blus-audio/hardware/readme.md

# Blus hardware

This repository contains hardware designs for the blus series of audio equipment.

- The [blus mini](./blus-mini) - a small 4x25 W digital amplifier with DSP and various digital inputs.
