blus-audio/hardware/blus-mini-mk2/kicad/blus-mini-mk2.kicad_pcb

## KiCad design blus-mini-mk2/kicad/blus-mini-mk2.kicad_pcb (2024-11-22)

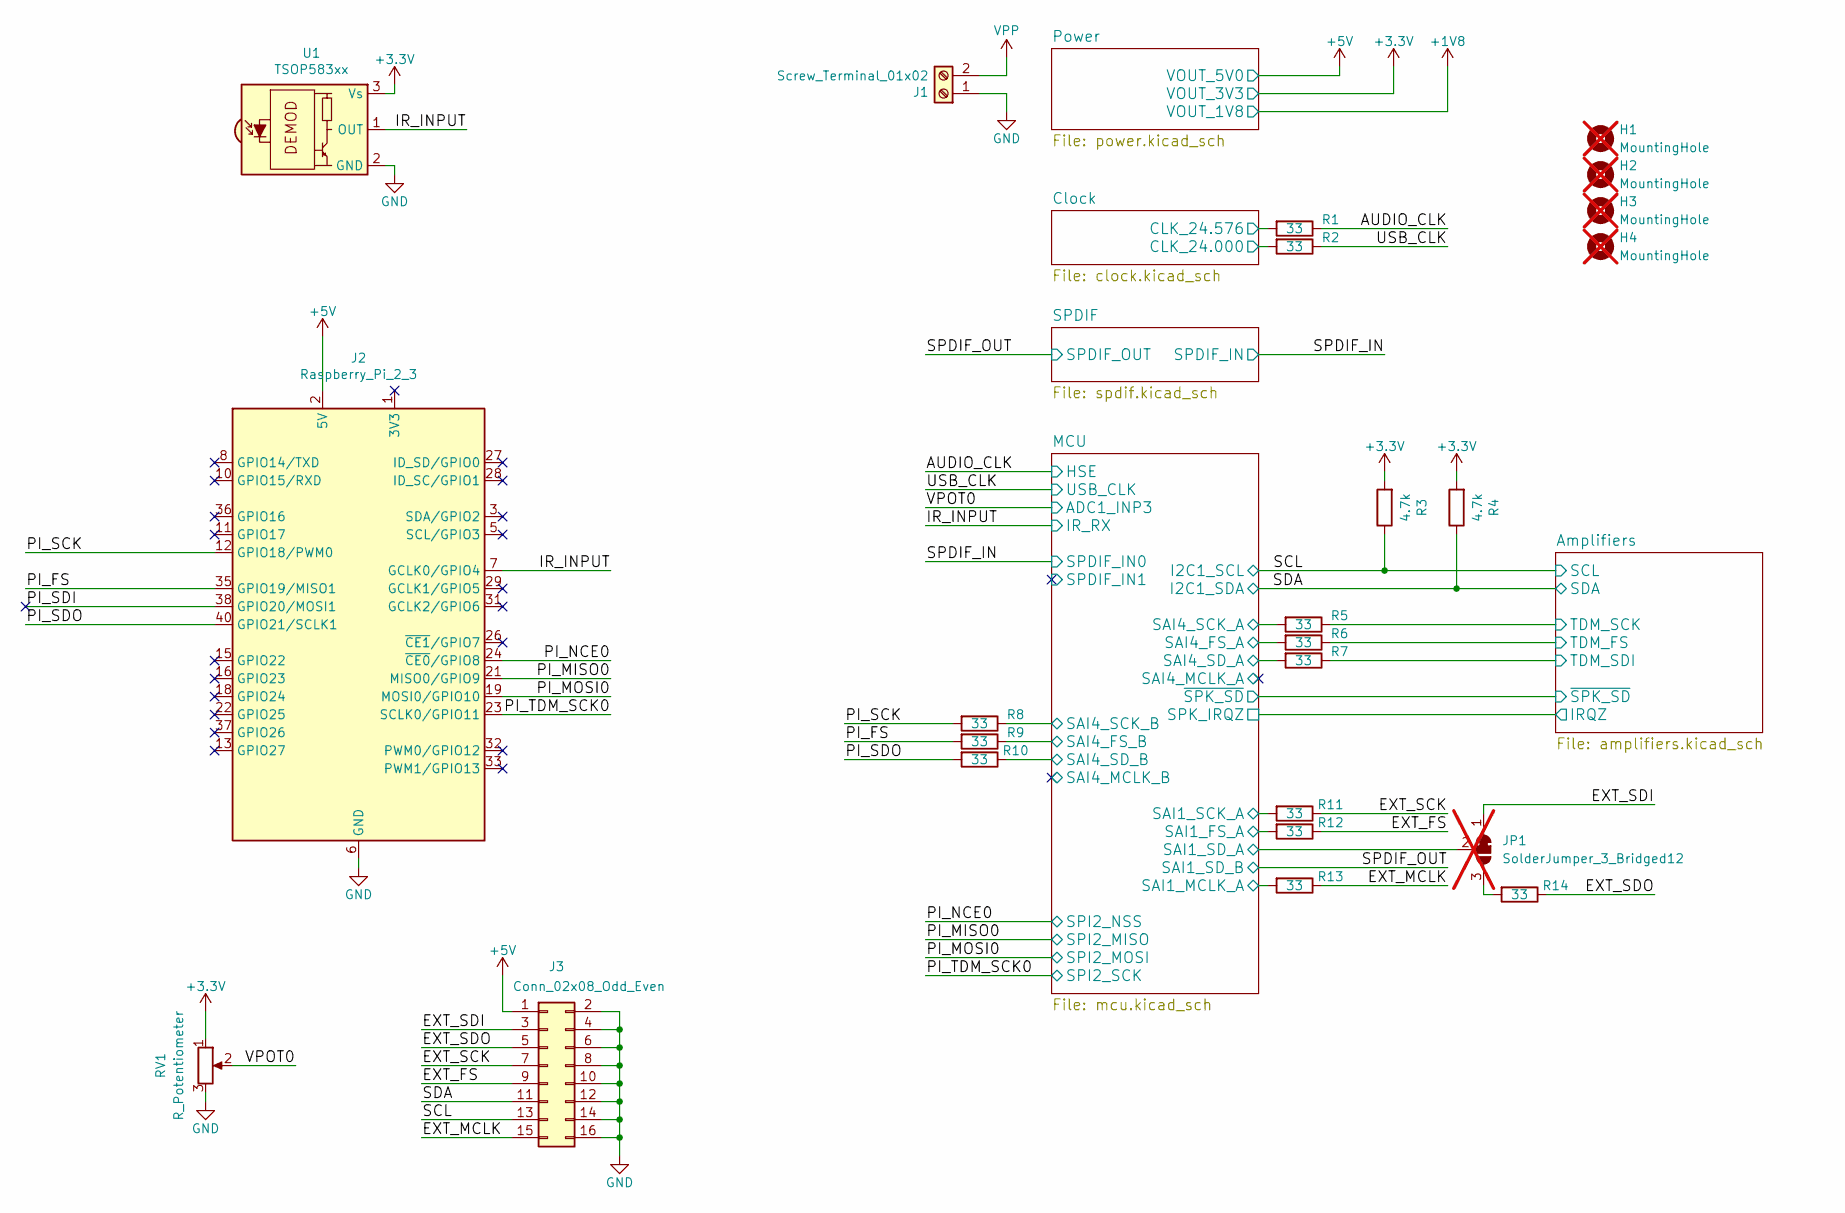
[picture p3: schematic blus-mini-mk2.kicad_sch, blus mini mk2]

Parts:
H1, H2, H3, H4: MountingHole; MountingHole_3.2mm_M3_ISO7380_Pad; not fitted
J1: Screw_Terminal_01x02; wuerth_691216410002
J2: Raspberry_Pi_2_3; PinSocket_2x20_P2.54mm_Vertical
J3: Conn_02x08_Odd_Even; IDC-Header_2x08_P2.54mm_Horizontal
JP1: SolderJumper_3_Bridged12; SolderJumper-3_P1.3mm_Bridged12_RoundedPad1.0x1.5mm; not fitted
R1, R2, R5, R6, R7, R8, R9, R10, R11, R12, R13, R14: 33; R_0402_1005Metric; MPN C25105
R3, R4: 4.7k; R_0402_1005Metric; MPN C25900
RV1: R_Potentiometer; Potentiometer_Bourns_PTV09A-1_Single_Vertical
U1: TSOP583xx; Vishay_MINICAST-3Pin

Connections:
+3.3V: R3.2, R4.2, RV1.1, U1.3 (Vs); also elsewhere on the board
+5V: J2.2 (5V), J2.4 (5V), J3.1; also elsewhere on the board
/AUDIO_CLK: R1.1; also elsewhere on the board
/Amplifiers/TDM_FS: R6.1; also elsewhere on the board
/Amplifiers/TDM_SCK: R5.1; also elsewhere on the board
/Amplifiers/TDM_SDI: R7.1; also elsewhere on the board
/Clock/CLK_24.000: R2.2; also elsewhere on the board
/Clock/CLK_24.576: R1.2; also elsewhere on the board
/EXT_FS: J3.9, R12.1
/EXT_MCLK: J3.15, R13.1
/EXT_SCK: J3.7, R11.1
/EXT_SDI: J3.3, JP1.1 (A)
/EXT_SDO: J3.5, R14.1
/IR_INPUT: J2.7 (GCLK0/GPIO4), U1.1 (OUT); also elsewhere on the board
/MCU/SAI1_FS_A: R12.2; also elsewhere on the board
/MCU/SAI1_MCLK_A: R13.2; also elsewhere on the board
/MCU/SAI1_SCK_A: R11.2; also elsewhere on the board
/MCU/SAI1_SD_A: JP1.2 (C); also elsewhere on the board
/MCU/SAI4_FS_A: R6.2; also elsewhere on the board
/MCU/SAI4_FS_B: R9.1; also elsewhere on the board
/MCU/SAI4_SCK_A: R5.2; also elsewhere on the board
/MCU/SAI4_SCK_B: R8.1; also elsewhere on the board
/MCU/SAI4_SD_A: R7.2; also elsewhere on the board
/MCU/SAI4_SD_B: R10.1; also elsewhere on the board
/PI_FS: J2.35 (GPIO19/MISO1), R9.2
/PI_MISO0: J2.21 (MISO0/GPIO9); also elsewhere on the board
/PI_MOSI0: J2.19 (MOSI0/GPIO10); also elsewhere on the board
/PI_NCE0: J2.24 (~CE0/GPIO8); also elsewhere on the board
/PI_SCK: J2.12 (GPIO18/PWM0), R8.2
/PI_SDI: J2.38 (GPIO20/MOSI1)
/PI_SDO: J2.40 (GPIO21/SCLK1), R10.2
/PI_TDM_SCK0: J2.23 (SCLK0/GPIO11); also elsewhere on the board
/SCL: J3.13, R3.1; also elsewhere on the board
/SDA: J3.11, R4.1; also elsewhere on the board
/USB_CLK: R2.1; also elsewhere on the board
/VPOT0: RV1.2; also elsewhere on the board
GND: J1.1, J2.6 (GND), J2.9 (GND), J2.14 (GND), J2.20 (GND), J2.25 (GND), J2.30 (GND), J2.34 (GND), J2.39 (GND), J3.2, J3.4, J3.6, J3.8, J3.10, J3.12, J3.14, J3.16, RV1.3, U1.2 (GND); also elsewhere on the board
unnamed: JP1.3 (B), R14.2
VPP: J1.2; also elsewhere on the board

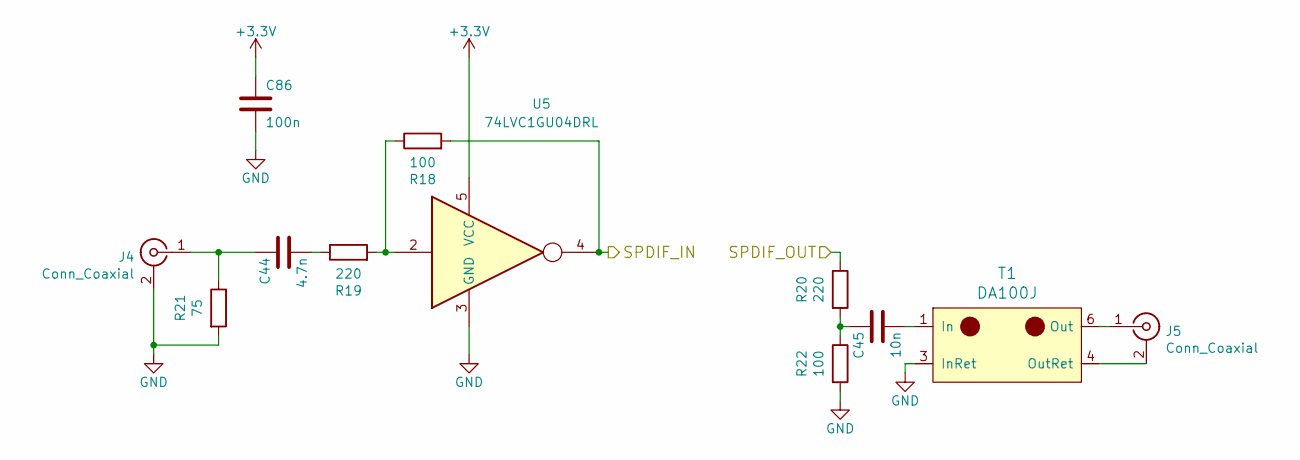
[picture p4: schematic spdif.kicad_sch, blus mini mk2]

Parts:
C44: 4.7n; C_0402_1005Metric
C45: 10n; C_0402_1005Metric; MPN C15195
C86: 100n; C_0402_1005Metric; MPN C307331
J4, J5: Conn_Coaxial; cui_rcj_02x
R18, R22: 100; R_0402_1005Metric; MPN C25076
R19, R20: 220; R_0402_1005Metric; MPN C25091
R21: 75; R_0402_1005Metric; MPN C25133
T1: DA100J; SOIC-6
U5: 74LVC1GU04DRL; SOT-553; MPN C2877548

Connections:
+3.3V: C86.1, U5.5 (VCC); also elsewhere on the board
/SPDIF_IN: R18.2, U5.4; also elsewhere on the board
/SPDIF_OUT: R20.1; also elsewhere on the board
GND: C86.2, J4.2 (Ext), R21.2, R22.2, T1.3 (InRet), U5.3 (GND); also elsewhere on the board
unnamed: C44.2, R19.1
unnamed: C45.1, R20.2, R22.1
unnamed: C44.1, J4.1 (In), R21.1
unnamed: J5.2 (Ext), T1.4 (OutRet)
unnamed: J5.1 (In), T1.6 (Out)
unnamed: R18.1, R19.2, U5.2
unnamed: C45.2, T1.1 (In)

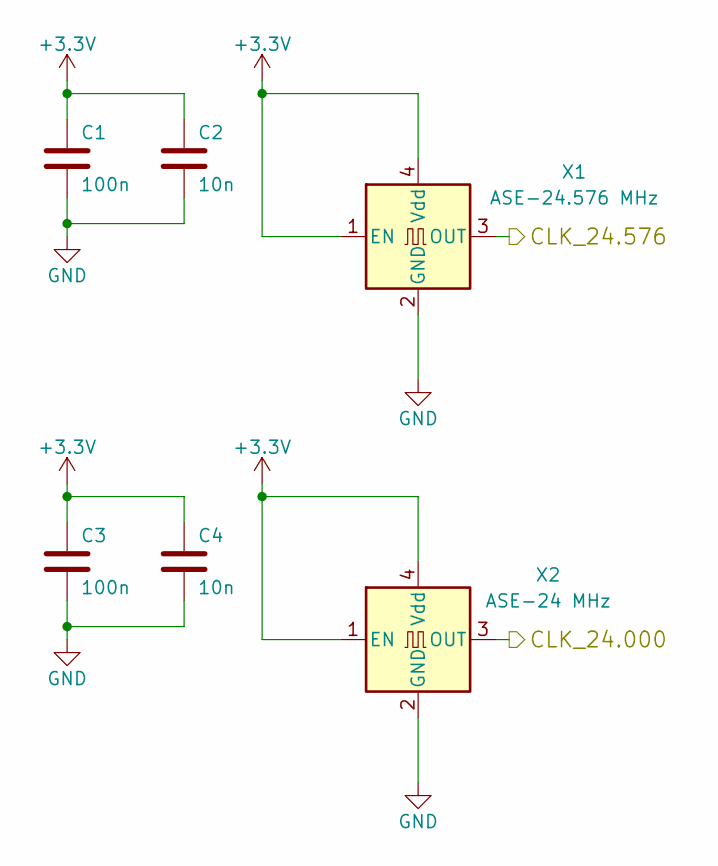
[picture p5: schematic clock.kicad_sch, blus mini mk2]

Parts:
C1, C3: 100n; C_0402_1005Metric; MPN C307331
C2, C4: 10n; C_0402_1005Metric; MPN C15195
X1: ASE-24.576 MHz; Oscillator_SMD_Abracon_ASE-4Pin_3.2x2.5mm
X2: ASE-24 MHz; Oscillator_SMD_Abracon_ASE-4Pin_3.2x2.5mm; MPN C507379

Connections:
+3.3V: C1.1, C2.1, C3.1, C4.1, X1.1 (EN), X1.4 (Vdd), X2.1 (EN), X2.4 (Vdd); also elsewhere on the board
/Clock/CLK_24.000: X2.3 (OUT); also elsewhere on the board
/Clock/CLK_24.576: X1.3 (OUT); also elsewhere on the board
GND: C1.2, C2.2, C3.2, C4.2, X1.2 (GND), X2.2 (GND); also elsewhere on the board

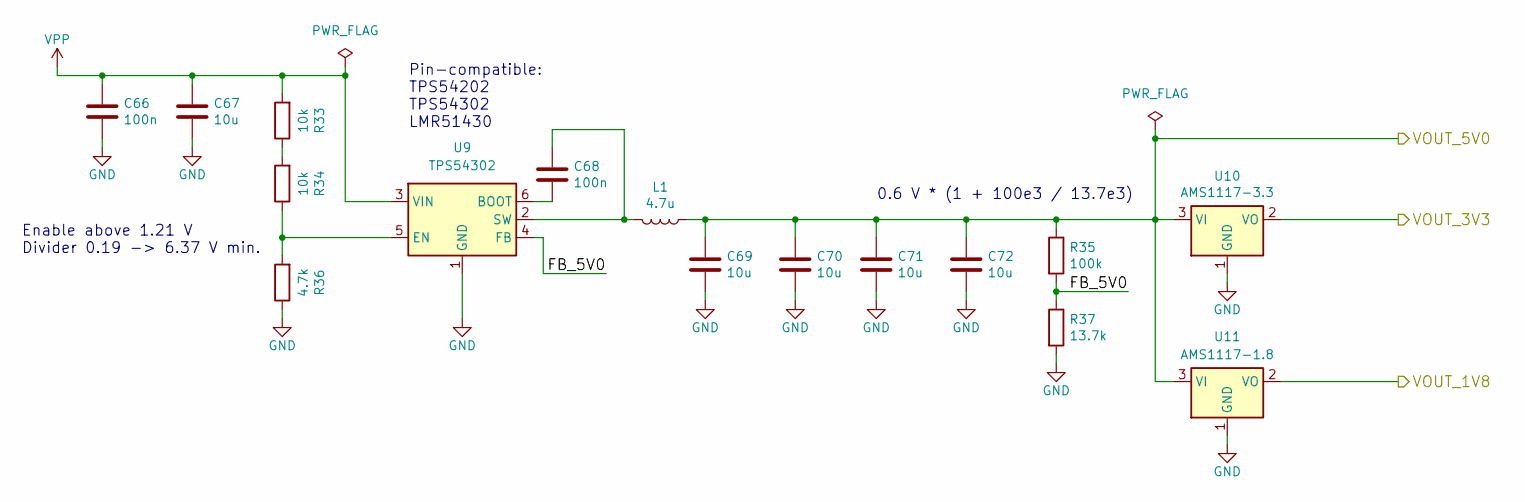
[picture p6: schematic power.kicad_sch, blus mini mk2]

Parts:
C66, C68: 100n; C_0402_1005Metric; MPN C307331
C67, C69, C70, C71, C72: 10u; C_1206_3216Metric; MPN C13585
L1: 4.7u; L_Abracon_ASPI-0630LR; MPN C167220
R33, R34: 10k; R_0402_1005Metric; MPN C25744
R35: 100k; R_0402_1005Metric; MPN C25741
R36: 4.7k; R_0402_1005Metric; MPN C25900
R37: 13.7k; R_0402_1005Metric
U9: TPS54302; SOT-23-6; MPN C311983; JLCPCB Rotation Offset -90
U10: AMS1117-3.3; SOT-223-3_TabPin2; MPN C6186
U11: AMS1117-1.8; SOT-223-3_TabPin2; MPN C6185

Connections:
+1V8: U11.2 (VO); also elsewhere on the board
+3.3V: U10.2 (VO); also elsewhere on the board
+5V: C69.1, C70.1, C71.1, C72.1, L1.1, R35.1, U10.3 (VI), U11.3 (VI); also elsewhere on the board
/Power/FB_5V0: R35.2, R37.1, U9.4 (FB)
GND: C66.2, C67.2, C69.2, C70.2, C71.2, C72.2, R36.1, R37.2, U9.1 (GND), U10.1 (GND), U11.1 (GND); also elsewhere on the board
unnamed: R33.1, R34.2
unnamed: C68.2, U9.6 (BOOT)
unnamed: R34.1, R36.2, U9.5 (EN)
unnamed: C68.1, L1.2, U9.2 (SW)
VPP: C66.1, C67.1, R33.2, U9.3 (VIN); also elsewhere on the board

Notes on the sheet:
0.6 V * (1 + 100e3 / 13.7e3)
Pin-compatible: TPS54202 TPS54302 LMR51430
Enable above 1.21 V Divider 0.19 -> 6.37 V min.

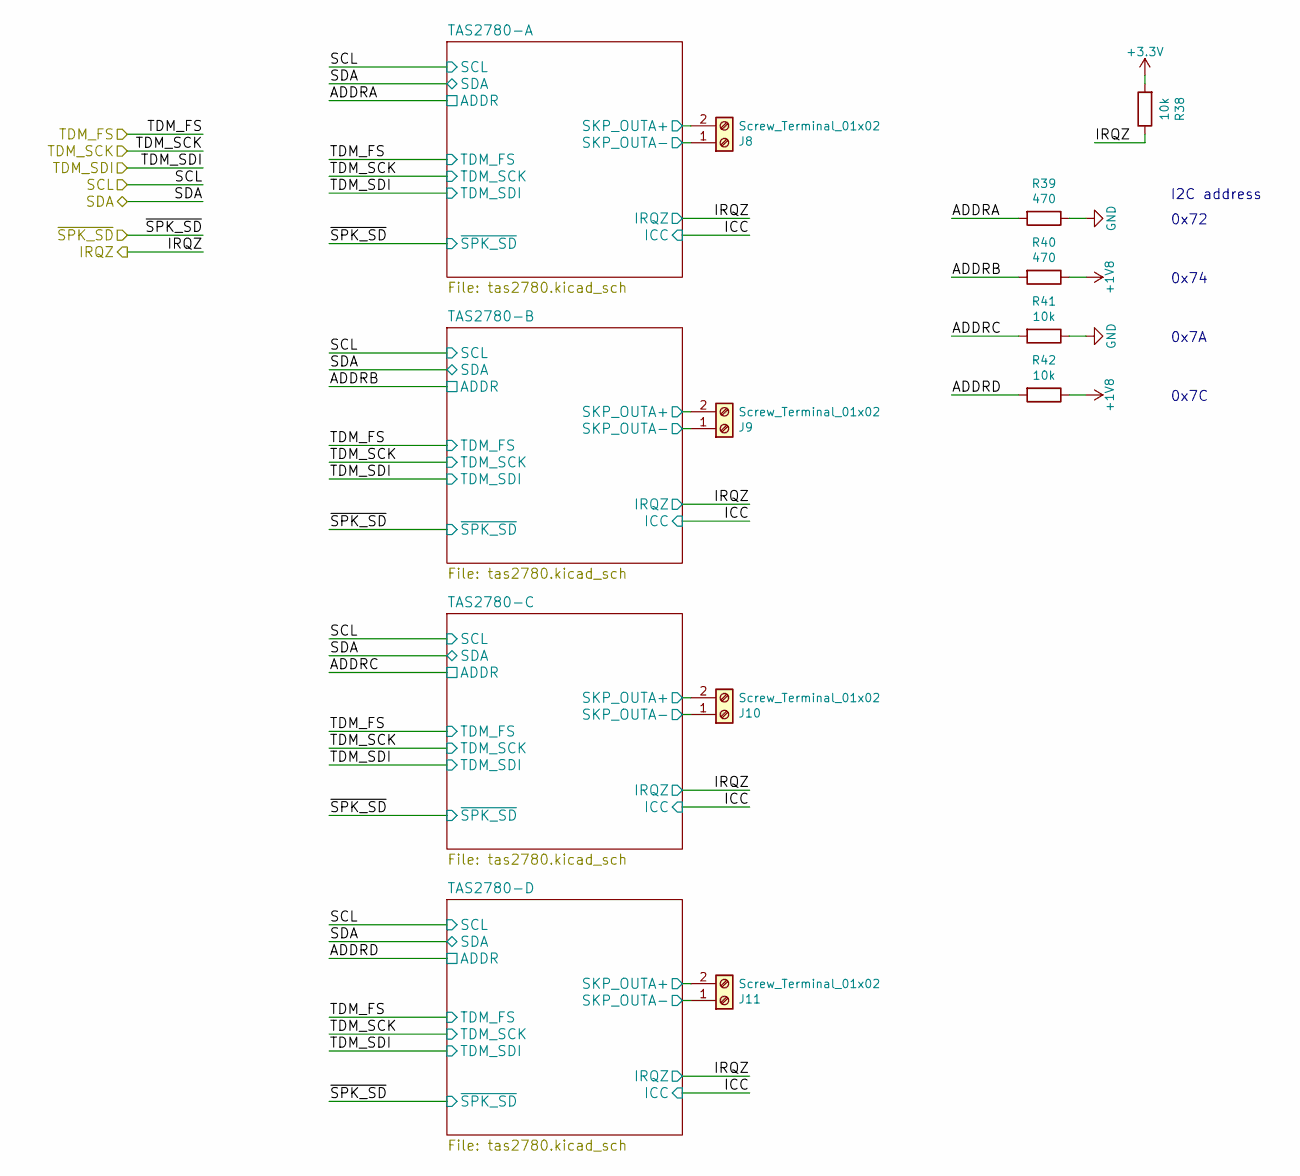
[picture p7: schematic amplifiers.kicad_sch, blus mini mk2]

Parts:
J8, J9, J10, J11: Screw_Terminal_01x02; wuerth_691216410002
R38, R41, R42: 10k; R_0402_1005Metric; MPN C25744
R39, R40: 470; R_0402_1005Metric; MPN C25117

Connections:
+1V8: R40.1, R42.1; also elsewhere on the board
+3.3V: R38.2; also elsewhere on the board
/Amplifiers/ADDRA: R39.2; also elsewhere on the board
/Amplifiers/ADDRB: R40.2; also elsewhere on the board
/Amplifiers/ADDRC: R41.2; also elsewhere on the board
/Amplifiers/ADDRD: R42.2; also elsewhere on the board
/Amplifiers/IRQZ: R38.1; also elsewhere on the board
/Amplifiers/TAS2780-A/SKP_OUTA+: J8.2; also elsewhere on the board
/Amplifiers/TAS2780-A/SKP_OUTA-: J8.1; also elsewhere on the board
/Amplifiers/TAS2780-B/SKP_OUTA+: J9.2; also elsewhere on the board
/Amplifiers/TAS2780-B/SKP_OUTA-: J9.1; also elsewhere on the board
/Amplifiers/TAS2780-C/SKP_OUTA+: J10.2; also elsewhere on the board
/Amplifiers/TAS2780-C/SKP_OUTA-: J10.1; also elsewhere on the board
/Amplifiers/TAS2780-D/SKP_OUTA+: J11.2; also elsewhere on the board
/Amplifiers/TAS2780-D/SKP_OUTA-: J11.1; also elsewhere on the board
GND: R39.1, R41.1; also elsewhere on the board

Notes on the sheet:
0x7C
0x72
0x7A
I2C address
0x74

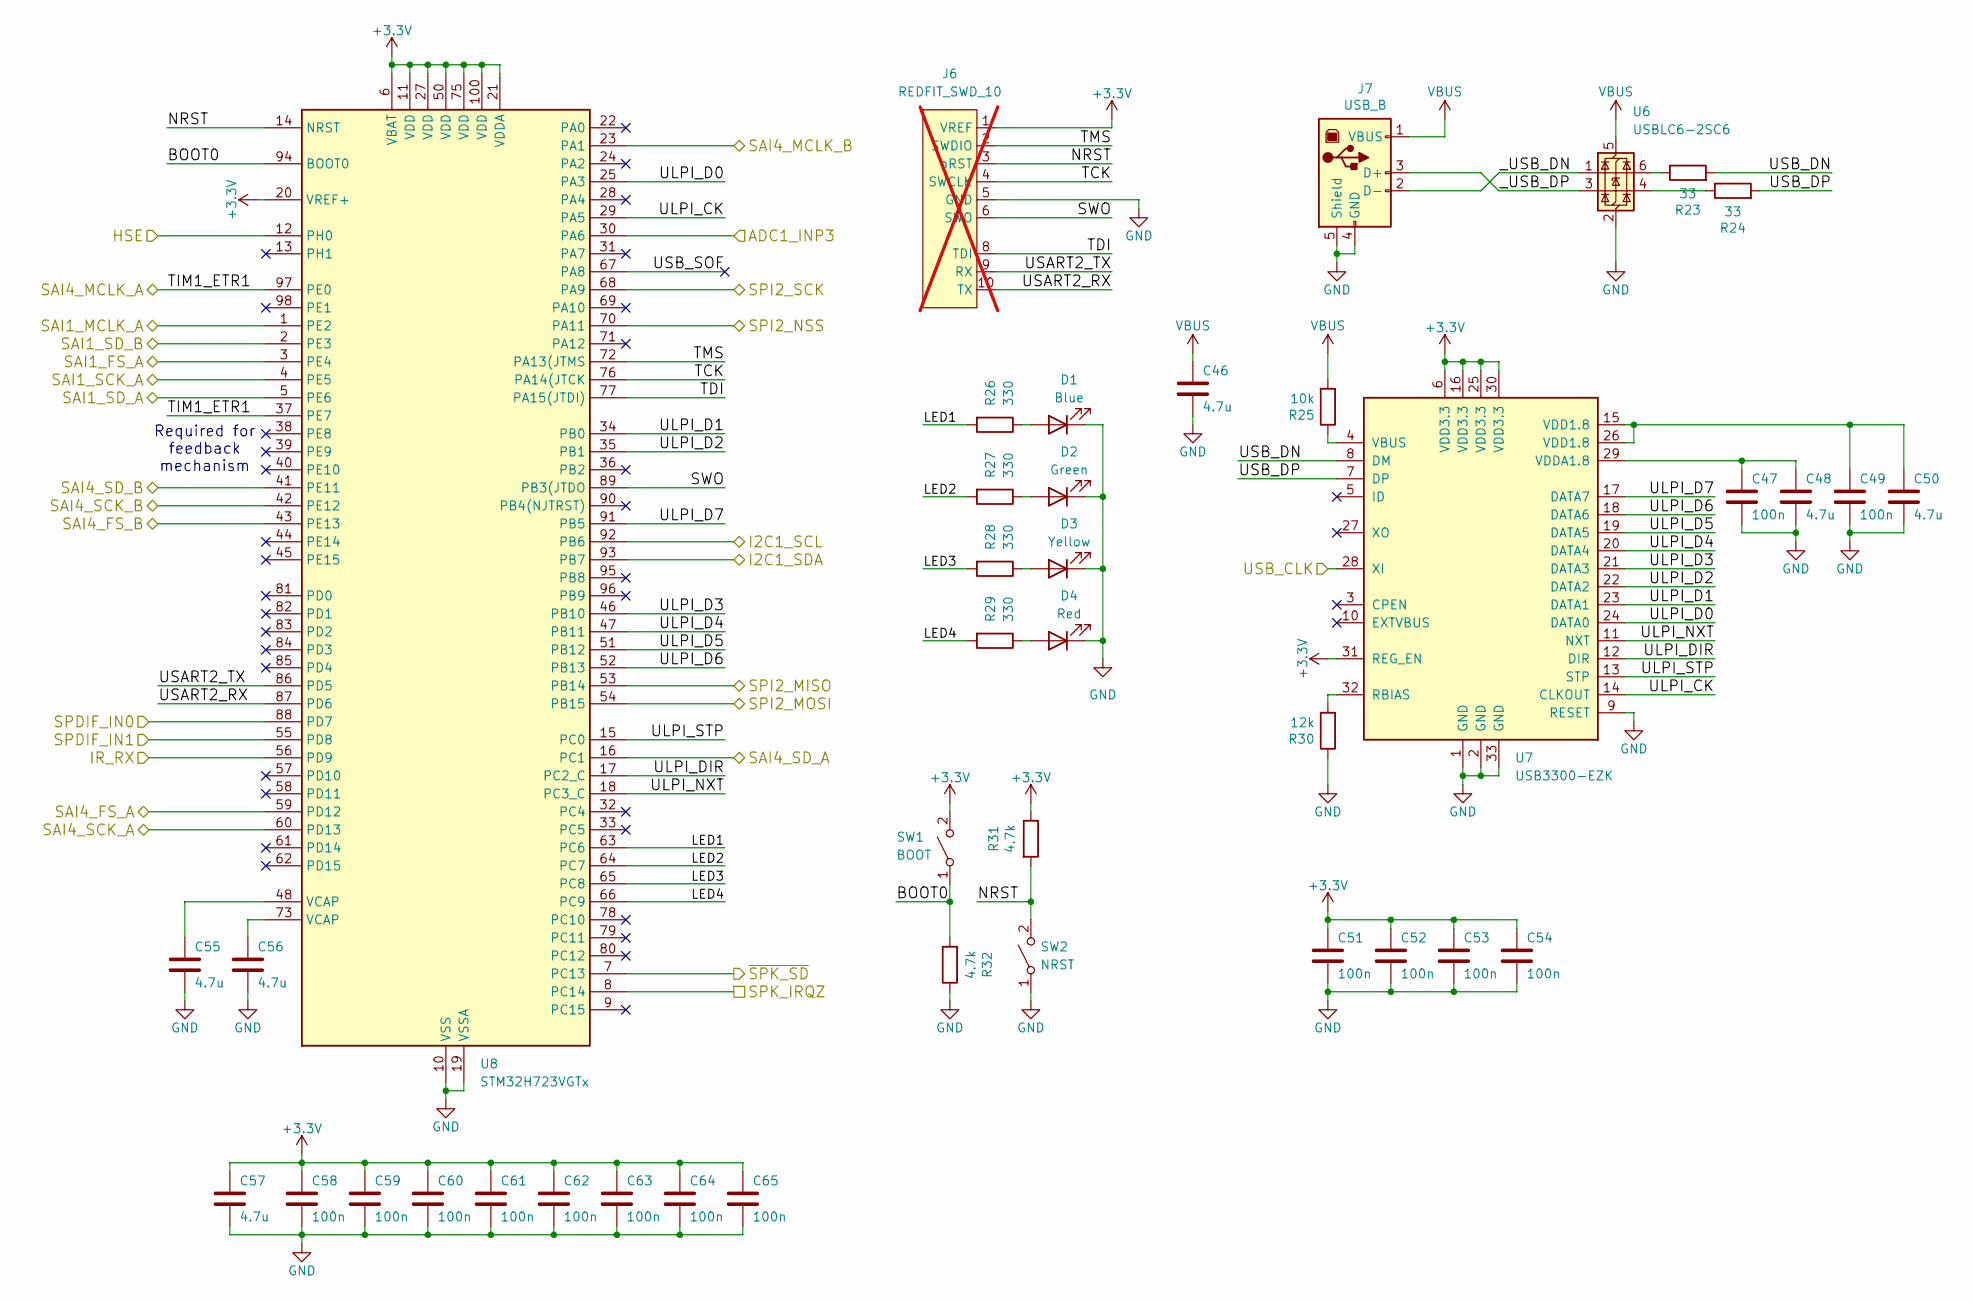
[picture p8: schematic mcu.kicad_sch, blus mini mk2]

Parts:
C46, C48, C50, C55, C56, C57: 4.7u; C_0805_2012Metric; MPN C1779
C47, C49, C51, C52, C53, C54, C58, C59, C60, C61, C62, C63, C64, C65: 100n; C_0402_1005Metric; MPN C307331
D1: Blue; LED_0603_1608Metric; MPN C72041
D2: Green; LED_0603_1608Metric; MPN C72043
D3: Yellow; LED_0603_1608Metric; MPN C72038
D4: Red; LED_0603_1608Metric; MPN C2286
J6: REDFIT_SWD_10; WR-WST REDFIT IDC 6 10 DBG; not fitted
J7: USB_B; USB_B_TE_5787834_Vertical; MPN C592900
R23, R24: 33; R_0402_1005Metric; MPN C25105
R25: 10k; R_0402_1005Metric; MPN C25744
R26, R27, R28, R29: 330; R_0402_1005Metric; MPN C25104
R30: 12k; R_0402_1005Metric; MPN C25752
R31, R32: 4.7k; R_0402_1005Metric; MPN C25900
SW1: BOOT; SW_SPST_TL3342; MPN C318884
SW2: NRST; SW_SPST_TL3342; MPN C318884
U6: USBLC6-2SC6; SOT-23-6; MPN C7519; JLCPCB Rotation Offset 90
U7: USB3300-EZK; QFN-32-1EP_5x5mm_P0.5mm_EP3.45x3.45mm; MPN C108383; JLCPCB Rotation Offset 180
U8: STM32H723VGTx; LQFP-100_14x14mm_P0.5mm; MPN C730142

Connections:
+3.3V: C51.1, C52.1, C53.1, C54.1, C57.1, C58.1, C59.1, C60.1, C61.1, C62.1, C63.1, C64.1, C65.1, J6.1 (VREF), R31.1, SW1.2 (B), U7.6 (VDD3.3), U7.16 (VDD3.3), U7.25 (VDD3.3), U7.30 (VDD3.3), U7.31 (REG_EN), U8.6 (VBAT), U8.11 (VDD), U8.20 (VREF+), U8.21 (VDDA), U8.27 (VDD), U8.50 (VDD), U8.75 (VDD), U8.100 (VDD); also elsewhere on the board
/AUDIO_CLK: U8.12 (PH0); also elsewhere on the board
/Amplifiers/IRQZ: U8.8 (PC14); also elsewhere on the board
/Amplifiers/~SPK_SD: U8.7 (PC13); also elsewhere on the board
/IR_INPUT: U8.56 (PD9); also elsewhere on the board
/MCU/BOOT0: R32.2, SW1.1 (A), U8.94 (BOOT0)
/MCU/LED1: R26.2, U8.63 (PC6)
/MCU/LED2: R27.2, U8.64 (PC7)
/MCU/LED3: R28.2, U8.65 (PC8)
/MCU/LED4: R29.2, U8.66 (PC9)
/MCU/NRST: J6.3 (nRST), R31.2, SW2.2 (B), U8.14 (NRST)
/MCU/SAI1_FS_A: U8.3 (PE4); also elsewhere on the board
/MCU/SAI1_MCLK_A: U8.1 (PE2); also elsewhere on the board
/MCU/SAI1_SCK_A: U8.4 (PE5); also elsewhere on the board
/MCU/SAI1_SD_A: U8.5 (PE6); also elsewhere on the board
/MCU/SAI4_FS_A: U8.59 (PD12); also elsewhere on the board
/MCU/SAI4_FS_B: U8.43 (PE13); also elsewhere on the board
/MCU/SAI4_MCLK_B: U8.23 (PA1)
/MCU/SAI4_SCK_A: U8.60 (PD13); also elsewhere on the board
/MCU/SAI4_SCK_B: U8.42 (PE12); also elsewhere on the board
/MCU/SAI4_SD_A: U8.16 (PC1); also elsewhere on the board
/MCU/SAI4_SD_B: U8.41 (PE11); also elsewhere on the board
/MCU/SPDIF_IN1: U8.55 (PD8)
/MCU/SWO: J6.6 (SWO), U8.89 (PB3(JTDO)
/MCU/TCK: J6.4 (SWCLK), U8.76 (PA14(JTCK)
/MCU/TDI: J6.8 (TDI), U8.77 (PA15(JTDI))
/MCU/TIM1_ETR1: U8.37 (PE7), U8.97 (PE0)
/MCU/TMS: J6.2 (SWDIO), U8.72 (PA13(JTMS)
/MCU/ULPI_CK: U7.14 (CLKOUT), U8.29 (PA5)
/MCU/ULPI_D0: U7.24 (DATA0), U8.25 (PA3)
/MCU/ULPI_D1: U7.23 (DATA1), U8.34 (PB0)
/MCU/ULPI_D2: U7.22 (DATA2), U8.35 (PB1)
/MCU/ULPI_D3: U7.21 (DATA3), U8.46 (PB10)
/MCU/ULPI_D4: U7.20 (DATA4), U8.47 (PB11)
/MCU/ULPI_D5: U7.19 (DATA5), U8.51 (PB12)
/MCU/ULPI_D6: U7.18 (DATA6), U8.52 (PB13)
/MCU/ULPI_D7: U7.17 (DATA7), U8.91 (PB5)
/MCU/ULPI_DIR: U7.12 (DIR), U8.17 (PC2_C)
/MCU/ULPI_NXT: U7.11 (NXT), U8.18 (PC3_C)
/MCU/ULPI_STP: U7.13 (STP), U8.15 (PC0)
/MCU/USART2_RX: J6.10 (TX), U8.87 (PD6)
/MCU/USART2_TX: J6.9 (RX), U8.86 (PD5)
/MCU/USB_DN: R23.2, U7.8 (DM)
/MCU/USB_DP: R24.2, U7.7 (DP)
/MCU/USB_SOF: U8.67 (PA8)
/MCU/_USB_DN: J7.2 (D-), U6.1 (I/O1)
/MCU/_USB_DP: J7.3 (D+), U6.3 (I/O2)
/PI_MISO0: U8.53 (PB14); also elsewhere on the board
/PI_MOSI0: U8.54 (PB15); also elsewhere on the board
/PI_NCE0: U8.70 (PA11); also elsewhere on the board
/PI_TDM_SCK0: U8.68 (PA9); also elsewhere on the board
/SCL: U8.92 (PB6); also elsewhere on the board
/SDA: U8.93 (PB7); also elsewhere on the board
/SPDIF_IN: U8.88 (PD7); also elsewhere on the board
/SPDIF_OUT: U8.2 (PE3); also elsewhere on the board
/USB_CLK: U7.28 (XI); also elsewhere on the board
/VPOT0: U8.30 (PA6); also elsewhere on the board
GND: C46.2, C47.2, C48.2, C49.2, C50.2, C51.2, C52.2, C53.2, C54.2, C55.2, C56.2, C57.2, C58.2, C59.2, C60.2, C61.2, C62.2, C63.2, C64.2, C65.2, D1.1 (K), D2.1 (K), D3.1 (K), D4.1 (K), J6.5 (GND), J7.4 (GND), J7.5 (Shield), R30.1, R32.1, SW2.1 (A), U6.2 (GND), U7.1 (GND), U7.2 (GND), U7.9 (RESET), U7.33 (GND), U8.10 (VSS), U8.19 (VSSA), U8.26 (VSS), U8.49 (VSS), U8.74 (VSS), U8.99 (VSS); also elsewhere on the board
unnamed: C49.1, C50.1, U7.15 (VDD1.8), U7.26 (VDD1.8)
unnamed: C55.1, U8.48 (VCAP)
unnamed: C56.1, U8.73 (VCAP)
unnamed: D1.2 (A), R26.1
unnamed: D2.2 (A), R27.1
unnamed: D3.2 (A), R28.1
unnamed: D4.2 (A), R29.1
unnamed: R23.1, U6.6 (I/O1)
unnamed: R24.1, U6.4 (I/O2)
unnamed: R30.2, U7.32 (RBIAS)
unnamed: R25.1, U7.4 (VBUS)
unnamed: C47.1, C48.1, U7.29 (VDDA1.8)
VBUS: C46.1, J7.1 (VBUS), R25.2, U6.5 (VBUS)

Notes on the sheet:
Required for feedback mechanism

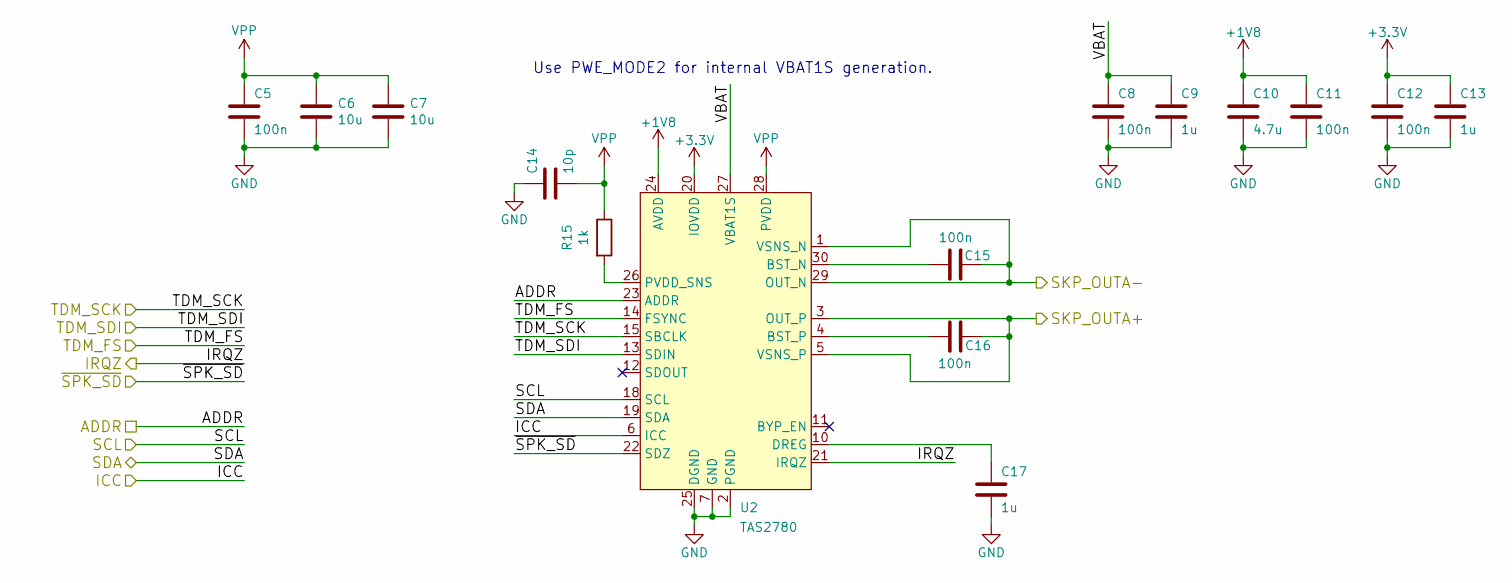
[picture p9: schematic tas2780.kicad_sch, blus mini mk2]

Parts:
C5, C8, C11, C12, C15, C16: 100n; C_0402_1005Metric; MPN C307331
C6, C7: 10u; C_1206_3216Metric; MPN C13585
C9, C13, C17: 1u; C_0603_1608Metric; MPN C15849
C10: 4.7u; C_0805_2012Metric; MPN C1779
C14: 10p; C_0402_1005Metric; MPN C32949
R15: 1k; R_0402_1005Metric; MPN C11702
U2: TAS2780; TI-30-Pin-HR-QFN; MPN C5214951

Connections:
+1V8: C10.1, C11.1, U2.24 (AVDD); also elsewhere on the board
+3.3V: C12.1, C13.1, U2.20 (IOVDD); also elsewhere on the board
/Amplifiers/ADDRA: U2.23 (ADDR); also elsewhere on the board
/Amplifiers/ICC: U2.6 (ICC); also elsewhere on the board
/Amplifiers/IRQZ: U2.21 (IRQZ); also elsewhere on the board
/Amplifiers/TAS2780-A/SKP_OUTA+: C16.1, U2.3 (OUT_P), U2.5 (VSNS_P); also elsewhere on the board
/Amplifiers/TAS2780-A/SKP_OUTA-: C15.2, U2.1 (VSNS_N), U2.29 (OUT_N); also elsewhere on the board
/Amplifiers/TAS2780-A/VBAT: C8.1, C9.1, U2.27 (VBAT1S)
/Amplifiers/TDM_FS: U2.14 (FSYNC); also elsewhere on the board
/Amplifiers/TDM_SCK: U2.15 (SBCLK); also elsewhere on the board
/Amplifiers/TDM_SDI: U2.13 (SDIN); also elsewhere on the board
/Amplifiers/~SPK_SD: U2.22 (SDZ); also elsewhere on the board
/SCL: U2.18 (SCL); also elsewhere on the board
/SDA: U2.19 (SDA); also elsewhere on the board
GND: C5.2, C6.2, C7.2, C8.2, C9.2, C10.2, C11.2, C12.2, C13.2, C14.1, C17.2, U2.2 (PGND), U2.7 (GND), U2.25 (DGND); also elsewhere on the board
unnamed: C15.1, U2.30 (BST_N)
unnamed: C16.2, U2.4 (BST_P)
unnamed: C17.1, U2.10 (DREG)
unnamed: R15.2, U2.26 (PVDD_SNS)
VPP: C5.1, C6.1, C7.1, C14.2, R15.1, U2.28 (PVDD); also elsewhere on the board

Parts of its further copies:
C18, C21, C24, C25, C28, C29, C31, C34, C37, C38, C41, C42, C73, C76, C79, C80, C83, C84: 100n; C_0402_1005Metric; MPN C307331
C19, C20, C32, C33, C74, C75: 10u; C_1206_3216Metric; MPN C13585
C22, C26, C30, C35, C39, C43, C77, C81, C85: 1u; C_0603_1608Metric; MPN C15849
C23, C36, C78: 4.7u; C_0805_2012Metric; MPN C1779
C27, C40, C82: 10p; C_0402_1005Metric; MPN C32949
R16, R17, R43: 1k; R_0402_1005Metric; MPN C11702
U3, U4, U12: TAS2780; TI-30-Pin-HR-QFN; MPN C5214951

Connections of its further copies:
+1V8: C23.1, C24.1, C36.1, C37.1, C78.1, C79.1, U3.24 (AVDD), U4.24 (AVDD), U12.24 (AVDD); also elsewhere on the board
+3.3V: C25.1, C26.1, C38.1, C39.1, C80.1, C81.1, U3.20 (IOVDD), U4.20 (IOVDD), U12.20 (IOVDD); also elsewhere on the board
/Amplifiers/ADDRB: U12.23 (ADDR); also elsewhere on the board
/Amplifiers/ADDRC: U3.23 (ADDR); also elsewhere on the board
/Amplifiers/ADDRD: U4.23 (ADDR); also elsewhere on the board
/Amplifiers/ICC: U3.6 (ICC), U4.6 (ICC), U12.6 (ICC); also elsewhere on the board
/Amplifiers/IRQZ: U3.21 (IRQZ), U4.21 (IRQZ), U12.21 (IRQZ); also elsewhere on the board
/Amplifiers/TAS2780-B/SKP_OUTA+: C84.1, U12.3 (OUT_P), U12.5 (VSNS_P); also elsewhere on the board
/Amplifiers/TAS2780-B/SKP_OUTA-: C83.2, U12.1 (VSNS_N), U12.29 (OUT_N); also elsewhere on the board
/Amplifiers/TAS2780-B/VBAT: C76.1, C77.1, U12.27 (VBAT1S)
/Amplifiers/TAS2780-C/SKP_OUTA+: C29.1, U3.3 (OUT_P), U3.5 (VSNS_P); also elsewhere on the board
/Amplifiers/TAS2780-C/SKP_OUTA-: C28.2, U3.1 (VSNS_N), U3.29 (OUT_N); also elsewhere on the board
/Amplifiers/TAS2780-C/VBAT: C21.1, C22.1, U3.27 (VBAT1S)
/Amplifiers/TAS2780-D/SKP_OUTA+: C42.1, U4.3 (OUT_P), U4.5 (VSNS_P); also elsewhere on the board
/Amplifiers/TAS2780-D/SKP_OUTA-: C41.2, U4.1 (VSNS_N), U4.29 (OUT_N); also elsewhere on the board
/Amplifiers/TAS2780-D/VBAT: C34.1, C35.1, U4.27 (VBAT1S)
/Amplifiers/TDM_FS: U3.14 (FSYNC), U4.14 (FSYNC), U12.14 (FSYNC); also elsewhere on the board
/Amplifiers/TDM_SCK: U3.15 (SBCLK), U4.15 (SBCLK), U12.15 (SBCLK); also elsewhere on the board
/Amplifiers/TDM_SDI: U3.13 (SDIN), U4.13 (SDIN), U12.13 (SDIN); also elsewhere on the board
/Amplifiers/~SPK_SD: U3.22 (SDZ), U4.22 (SDZ), U12.22 (SDZ); also elsewhere on the board
/SCL: U3.18 (SCL), U4.18 (SCL), U12.18 (SCL); also elsewhere on the board
/SDA: U3.19 (SDA), U4.19 (SDA), U12.19 (SDA); also elsewhere on the board
GND: C18.2, C19.2, C20.2, C21.2, C22.2, C23.2, C24.2, C25.2, C26.2, C27.1, C30.2, C31.2, C32.2, C33.2, C34.2, C35.2, C36.2, C37.2, C38.2, C39.2, C40.1, C43.2, C73.2, C74.2, C75.2, C76.2, C77.2, C78.2, C79.2, C80.2, C81.2, C82.1, C85.2, U3.2 (PGND), U3.7 (GND), U3.25 (DGND), U4.2 (PGND), U4.7 (GND), U4.25 (DGND), U12.2 (PGND), U12.7 (GND), U12.25 (DGND); also elsewhere on the board
unnamed: C28.1, U3.30 (BST_N)
unnamed: C29.2, U3.4 (BST_P)
unnamed: C30.1, U3.10 (DREG)
unnamed: R16.2, U3.26 (PVDD_SNS)
unnamed: C41.1, U4.30 (BST_N)
unnamed: C42.2, U4.4 (BST_P)
unnamed: C43.1, U4.10 (DREG)
unnamed: R17.2, U4.26 (PVDD_SNS)
unnamed: C83.1, U12.30 (BST_N)
unnamed: C84.2, U12.4 (BST_P)
unnamed: C85.1, U12.10 (DREG)
unnamed: R43.2, U12.26 (PVDD_SNS)
VPP: C18.1, C19.1, C20.1, C27.2, C31.1, C32.1, C33.1, C40.2, C73.1, C74.1, C75.1, C82.2, R16.1, R17.1, R43.1, U3.28 (PVDD), U4.28 (PVDD), U12.28 (PVDD); also elsewhere on the board

Notes on the sheet:
Use PWE_MODE2 for internal VBAT1S generation.

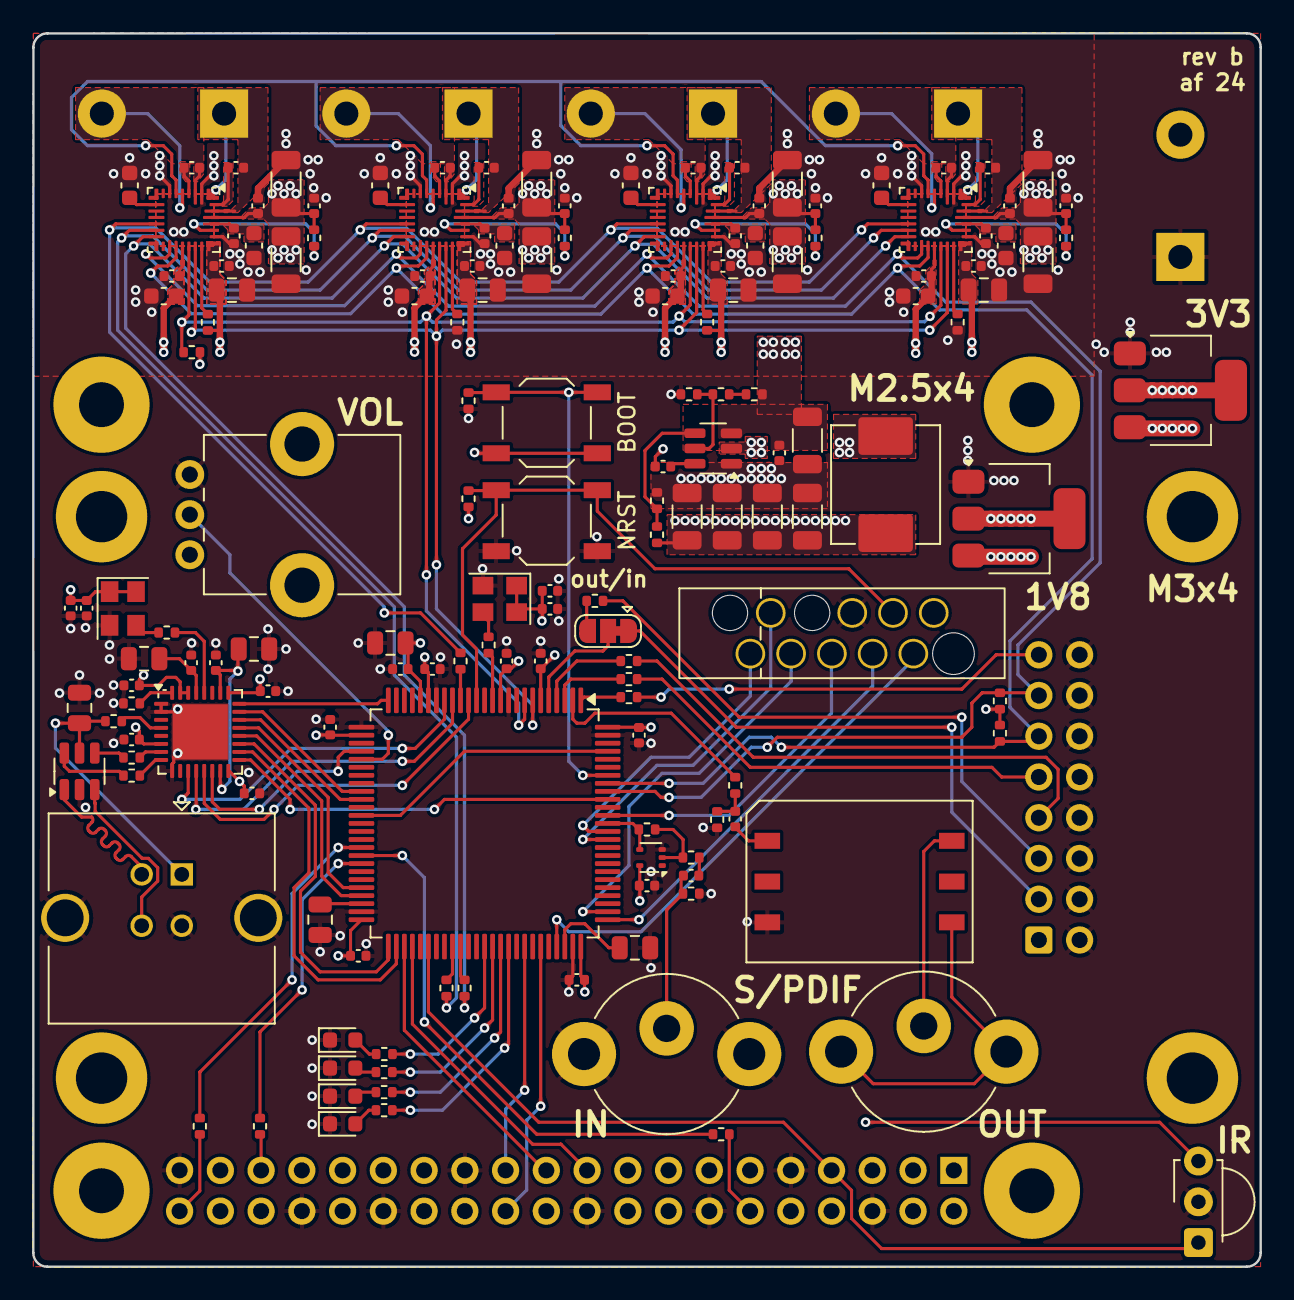
[picture p10: board blus-mini-mk2.kicad_pcb from above]

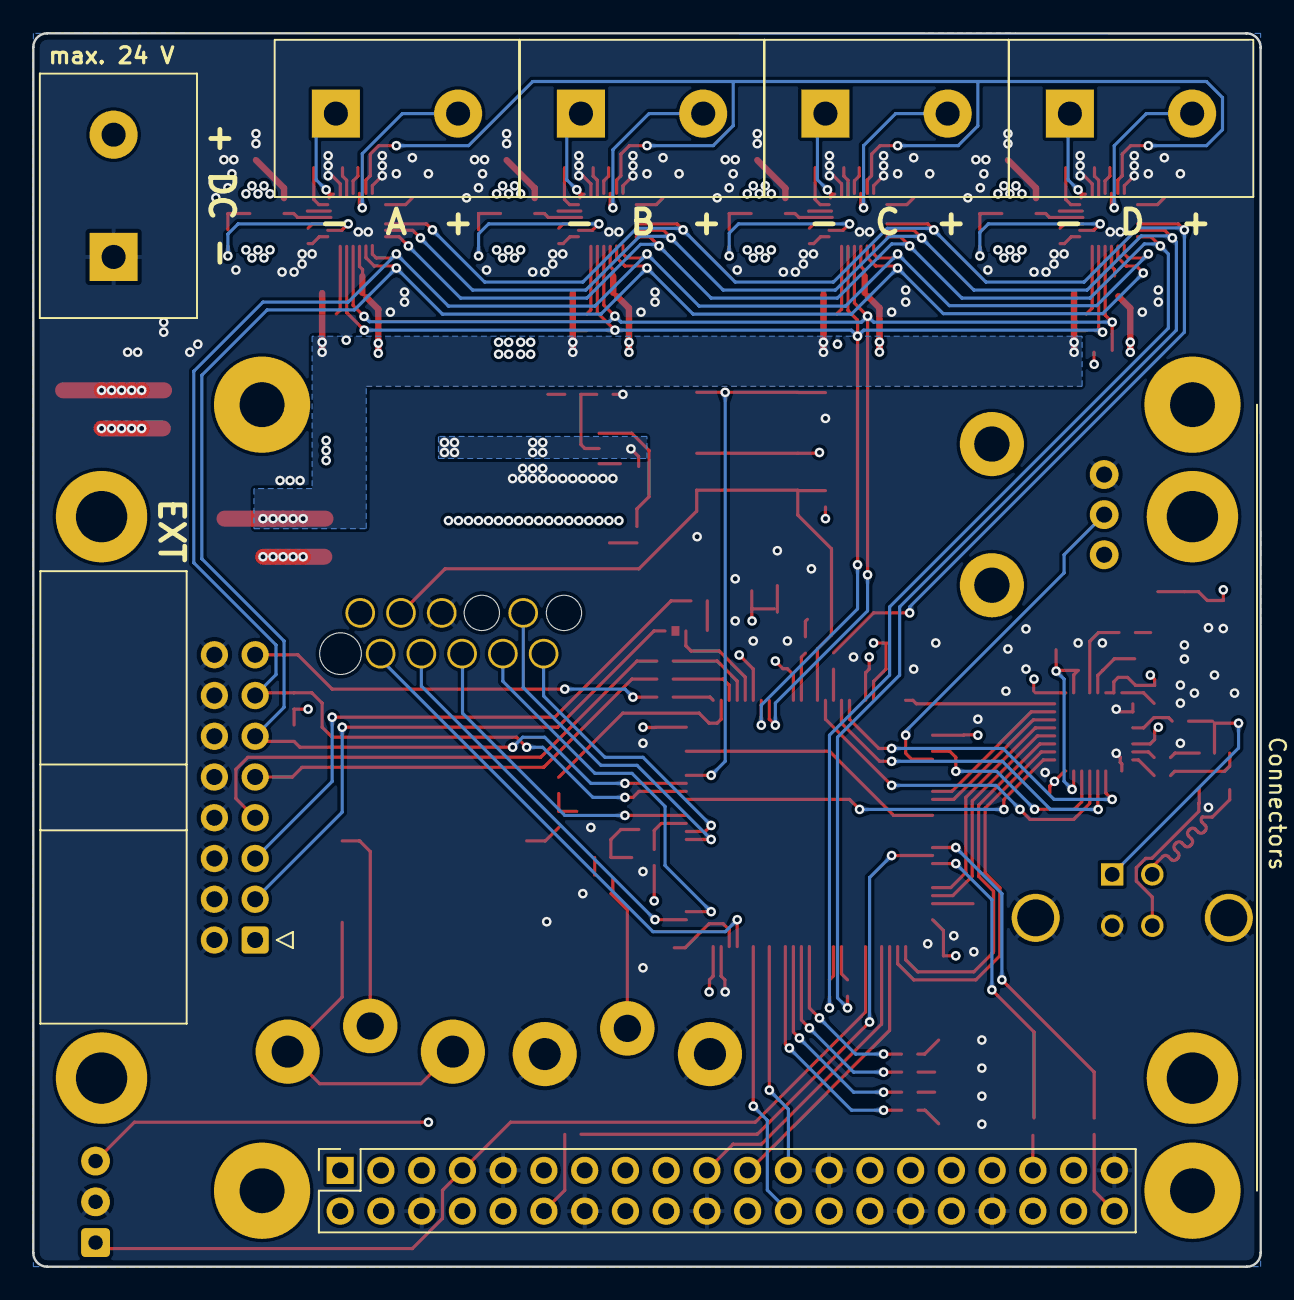
[picture p11: board blus-mini-mk2.kicad_pcb from below]

Board: 4 copper layers, 76.5 x 76.9 mm, 168 parts (7 on the bottom side), 130 nets.
