blus-audio/hardware/Hardware/dsp-amplifier-x4.kicad_pcb

## KiCad design Hardware/dsp-amplifier-x4.kicad_pcb (2022-10-16)

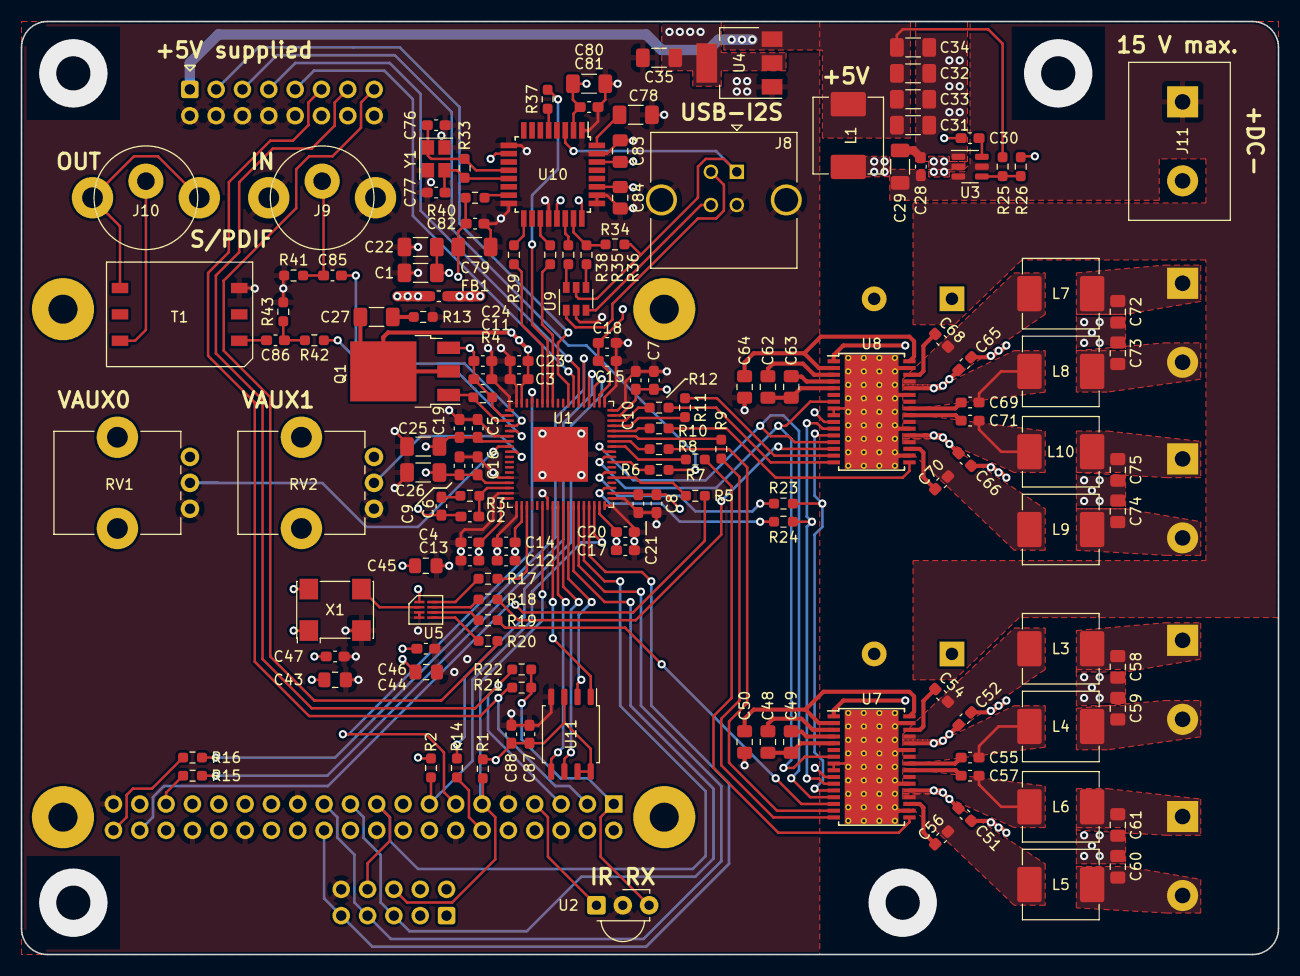
[picture p12: board dsp-amplifier-x4.kicad_pcb from above]

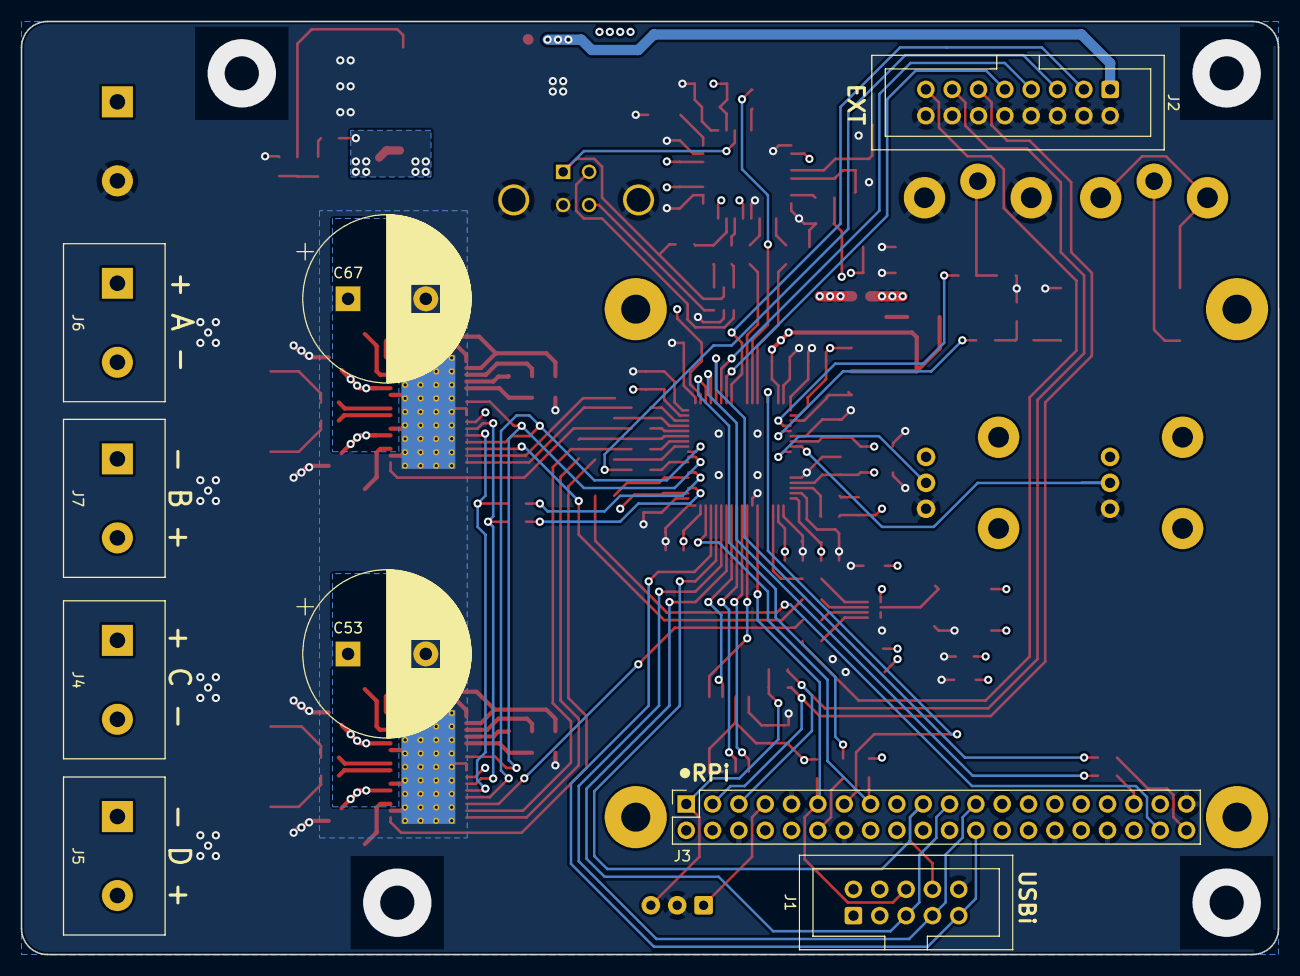
[picture p13: board dsp-amplifier-x4.kicad_pcb from below]

Board: 4 copper layers, 121.2 x 90.0 mm, 155 parts (9 on the bottom side), 126 nets.

Parts:
C1, C22, C25, C26, C27, C29, C31, C32, C33, C34, C35, C78, C79, C80: 10u; C_1206_3216Metric_Pad1.33x1.80mm_HandSolder
C2: 150p; C_0603_1608Metric_Pad1.08x0.95mm_HandSolder
C3, C4, C5, C10, C11, C14, C15, C16, C20, C21, C47, C85, C86, C87: 10n; C_0603_1608Metric_Pad1.08x0.95mm_HandSolder
C6: 5.6n; C_0603_1608Metric_Pad1.08x0.95mm_HandSolder
C7, C8, C9, C12, C13, C17, C18, C19, C23, C24, C28, C30, C46, C51, C52, C65, C66, C81, C82, C88: 100n; C_0603_1608Metric_Pad1.08x0.95mm_HandSolder
C43, C44, C45, C48, C49, C50, C62, C63, C64, C83, C84: 1u; C_0805_2012Metric_Pad1.18x1.45mm_HandSolder
C53, C67: 470u; CP_Radial_D16.0mm_P7.50mm
C54, C55, C56, C57, C68, C69, C70, C71: 220n; C_0603_1608Metric_Pad1.08x0.95mm_HandSolder
C58, C59, C60, C61, C72, C73, C74, C75: 680n; C_0805_2012Metric_Pad1.18x1.45mm_HandSolder
C76, C77: 33p; C_0603_1608Metric_Pad1.08x0.95mm_HandSolder
FB1: BLM18SP601SZ1D (600/100M); L_0603_1608Metric_Pad1.05x0.95mm_HandSolder
J1: USBi; IDC-Header_2x05_P2.54mm_Vertical
J2: EXT; IDC-Header_2x08_P2.54mm_Vertical
J3: Raspberry_Pi_2_3; PinSocket_2x20_P2.54mm_Vertical
J4, J5, J6, J7, J11: Screw_Terminal_01x02; wuerth_691216410002
J8: USB_B; USB_B_TE_5787834_Vertical
J9, J10: Conn_Coaxial; cui_rcj_02x
L1: 4.7u; L_Abracon_ASPI-0630LR
L3, L4, L5, L6, L7, L8, L9, L10: 10u; L_Abracon_ASPI-0630LR
Q1: STD2805; TO-252-3_TabPin2
R1, R2, R3, R4, R21, R22, R23, R24: 4.3k; R_0603_1608Metric_Pad0.98x0.95mm_HandSolder
R5, R6, R7, R8, R9, R10, R11, R12, R14, R15, R16, R17, R18, R19, R20, R35, R36, R37, R38, R39: 33; R_0603_1608Metric_Pad0.98x0.95mm_HandSolder
R13: 0.47; R_0603_1608Metric_Pad0.98x0.95mm_HandSolder
R25: 54.9k; R_0603_1608Metric_Pad0.98x0.95mm_HandSolder
R26: 10k; R_0603_1608Metric_Pad0.98x0.95mm_HandSolder
R33: 1M; R_0603_1608Metric_Pad0.98x0.95mm_HandSolder
R34, R40: 1.5k; R_0603_1608Metric_Pad0.98x0.95mm_HandSolder
R41: 75; R_0603_1608Metric_Pad0.98x0.95mm_HandSolder
R42: 243; R_0603_1608Metric_Pad0.98x0.95mm_HandSolder
R43: 107; R_0603_1608Metric_Pad0.98x0.95mm_HandSolder
RV1, RV2: PTV09A-1020F-B203; Potentiometer_Bourns_PTV09A-1_Single_Vertical
T1: DA100J; SOIC-6
U1: ADAU1452; LFCSP-72-1EP_10x10mm_P0.5mm_EP5.3x5.3mm
U2: TSOP583xx; Vishay_MINICAST-3Pin
U3: TPS563200; SOT-23-6
U4: AMS1117-3.3; SOT-223-3_TabPin2
U5: 74AVC9112; NXP_XSON-8
U7, U8: TAS5760MDCAR; HTSSOP-32-1EP_6.1x11mm_P0.65mm_EP5.2x11mm_Mask4.11x4.36mm_T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
U9: USBLC6-2SC6; SOT-23-6
U10: PCM2707; TQFP-32_7x7mm_P0.8mm
U11: 25LCxxx; SOIC-8_5.275x5.275mm_P1.27mm
X1: ASV-24.576MHz-EJ-T; Oscillator_SMD_Abracon_ASV-4Pin_7.0x5.1mm
Y1: 12 MHz; Crystal_SMD_SeikoEpson_FA238-4Pin_3.2x2.5mm

Connections:
+3.3VA: C2.1, C5.1, C6.1, C9.1, C16.1, C19.1, C25.1, C26.1, C35.1, FB1.2, RV1.1, RV2.1, U1.7 (AVDD), U1.15 (PVDD), U4.2 (VO)
+3V3: C1.1, C4.1, C8.1, C11.1, C13.1, C15.1, C18.1, C21.1, C22.1, C24.1, C43.1, C44.1, C45.1, C46.1, C47.1, C79.1, C80.1, C81.1, C82.1, C83.1, C84.1, C87.1, C88.1, FB1.1, Q1.3 (E), R1.2, R2.2, R4.1, R40.2, U1.2 (IOVDD), U1.18 (IOVDD), U1.38 (IOVDD), U1.56 (IOVDD), U5.1 (VCC), U7.10 (DVDD), U8.10 (DVDD), U10.2 (VCCP), U10.10 (TEST), U10.21 (VDD), U10.24 (VBUS), U10.27 (VCCL), U10.30 (VCCR), U11.3 (~WP), U11.7 (~HOLD), U11.8 (VCC), X1.1 (EN), X1.4 (Vdd)
+5VA: C31.1, C32.1, C33.1, C34.1, J2.1, J3.2 (5V), J3.4 (5V), L1.1, R25.1, U4.3 (VI)
+15V: C28.1, C29.1, J11.1, U3.3 (VIN), U3.5 (EN)
/AMP1_BCLK: R8.1, U7.15 (SCLK)
/AMP1_CLOCK: R19.2, U7.14 (MCLK)
/AMP1_LRCLK: R7.1, U7.17 (LRCK)
/AMP1_SDIN: R9.1, U7.16 (SDIN)
/AMP2_BCLK: R11.1, U8.15 (SCLK)
/AMP2_CLOCK: R18.2, U8.14 (MCLK)
/AMP2_LRCLK: R10.1, U8.17 (LRCK)
/AMP2_SDIN: R12.1, U8.16 (SDIN)
/AMP_NSPK_SD: U1.45 (MP6), U7.7 (!SPK_SD), U8.7 (!SPK_SD)
/AMP_SPK_SLEEP: U1.46 (MP7), U7.13 (SPK_SLEEP/ADR), U8.13 (SPK_SLEEP/ADR)
/Clock/CLK0: R20.1, U5.5 (Y1)
/Clock/CLK1: R19.1, U5.6 (Y2)
/Clock/CLK2: R18.1, U5.7 (Y3)
/Clock/CLK3: R17.1, U5.8 (Y4)
/DSP_CLOCK: R17.2, U1.21 (XTALIN/MCLK)
/DSP_NRESET: J1.6, J3.11 (GPIO17), R1.1, U1.24 (~RESET)
/DSP_SELFBOOT: J3.15 (GPIO22), R2.1, U1.34 (SELFBOOT)
/DVDD: C3.1, C7.1, C10.1, C12.1, C14.1, C17.1, C20.1, C23.1, C27.1, Q1.2 (C), U1.20 (DVDD), U1.35 (DVDD), U1.53 (DVDD), U1.71 (DVDD)
/EEPROM_MISO: U1.29 (SDA_M/MISO_M/MP3), U11.2 (MISO)
/EEPROM_MOSI: U1.27 (MOSI_M/MP1), U11.5 (MOSI)
/EEPROM_NCS: U1.26 (SS_M/MP0), U11.1 (~CS)
/EEPROM_SCK: U1.28 (SCL_M/SCLK_M/MP2), U11.6 (SCK)
/EXT_BCLK: J2.7, U1.60 (BCLK_IN1)
/EXT_LRCLK: J2.9, U1.61 (LRCLK_IN1/MP11)
/EXT_MCLK: J2.15, R20.2
/EXT_MDI: J2.3, U1.62 (SDATA_IN1)
/EXT_MDO: J2.5, R6.1
/GAIN0: R24.1, U7.11 (SPK_GAIN0), U8.11 (SPK_GAIN0)
/GAIN0_OUT: R24.2, U1.39 (LRCLK_OUT0/MP4)
/GAIN1: R23.1, U7.12 (SPK_GAIN1), U8.12 (SPK_GAIN1)
/GAIN1_OUT: R23.2, U1.42 (LRCLK_OUT1/MP5)
/I2S-AMP-2CH-A/SKP_OUTA+: C58.2, J4.1, L3.2
/I2S-AMP-2CH-A/SKP_OUTA-: C59.2, J4.2, L4.2
/I2S-AMP-2CH-A/SKP_OUTB+: C60.2, J5.2, L5.2
/I2S-AMP-2CH-A/SKP_OUTB-: C61.2, J5.1, L6.2
/I2S-AMP-2CH-B/SKP_OUTA+: C72.2, J6.1, L7.2
/I2S-AMP-2CH-B/SKP_OUTA-: C73.2, J6.2, L8.2
/I2S-AMP-2CH-B/SKP_OUTB+: C74.2, J7.2, L9.2
/I2S-AMP-2CH-B/SKP_OUTB-: C75.2, J7.1, L10.2
/IR_INPUT: J3.7 (GCLK0/GPIO4), U2.1 (OUT)
/PI_BCLK: R14.2, U1.57 (BCLK_IN0)
/PI_LRCLK: R15.2, U1.58 (LRCLK_IN0/MP10)
/PI_MISO0: J1.5, J3.21 (MISO0/GPIO9), U1.30 (MISO/SDA)
/PI_MOSI0: J1.8, J3.19 (MOSI0/GPIO10), U1.32 (MOSI/ADDR1)
/PI_NCE0: J1.9, J3.24 (~CE0/GPIO8), U1.33 (SS/ADDR0)
/PI_SCL: J2.13, J3.5 (SCL/GPIO3), R22.1
/PI_SCLK0: J1.7, J3.23 (SCLK0/GPIO11), U1.31 (SCLK/SCL)
/PI_SDA: J2.11, J3.3 (SDA/GPIO2), R21.1
/PI_SDATA_I: J3.38 (GPIO20/MOSI1), R5.1
/PI_SDATA_O: R16.2, U1.59 (SDATA_IN0)
/Power-15V/FB_5V0: R25.2, R26.1, U3.4 (VFB)
/SPDIF_IN: C85.2, U1.4 (SPDIFIN)
/SPDIF_OUT: R42.1, U1.5 (SPDIFOUT)
/USB I2S/USB-DM: R35.2, U10.22 (D-)
/USB I2S/USB-DP: R34.1, R36.2, U10.23 (D+)
/USB_BCLK: R38.1, U1.65 (BCLK_IN2)
/USB_LRCLK: R37.1, U1.66 (LRCLK_IN2/MP12)
/USB_SDATA: R39.1, U1.67 (SDATA_IN2)
/VDRIVE: Q1.1 (B), R4.2, U1.3 (VDRIVE)
/VPOT0: RV1.2, U1.8 (AUXADC0)
/VPOT1: RV2.2, U1.9 (AUXADC1)
GND: C1.2, C3.2, C4.2, C5.2, C7.2, C8.2, C9.2, C10.2, C11.2, C12.2, C13.2, C14.2, C15.2, C16.2, C17.2, C18.2, C19.2, C20.2, C21.2, C22.2, C23.2, C24.2, C25.2, C26.2, C28.2, C29.2, C31.2, C32.2, C33.2, C34.2, C35.2, C43.2, C44.2, C45.2, C46.2, C47.2, C50.2, C51.2, C52.2, C53.2, C58.1, C59.1, C60.1, C61.1, C64.2, C65.2, C66.2, C67.2, C72.1, C73.1, C74.1, C75.1, C76.2, C77.2, C78.2, C79.2, C80.2, C81.2, C82.2, C83.2, C84.2, C87.2, C88.2, J1.10, J2.2, J2.4, J2.6, J2.8, J2.10, J2.12, J2.14, J2.16, J3.6 (GND), J3.9 (GND), J3.14 (GND), J3.20 (GND), J3.25 (GND), J3.30 (GND), J3.34 (GND), J3.39 (GND), J8.4 (GND), J8.5 (Shield), J9.2 (Ext), J11.2, R13.1, R26.2, R41.2, R43.2, RV1.3, RV2.3, T1.3 (InRet), U1.1 (DGND), U1.6 (AGND), U1.14 (PGND), U1.17 (DGND), U1.19 (DGND), U1.25 (DGND), U1.36 (DGND), U1.37 (DGND), U1.54 (DGND), U1.55 (DGND), U1.72 (DGND), U1.73 (EP), U2.2 (GND), U3.1 (GND), U4.1 (GND), U5.3 (NOE), U5.4 (GND), U7.8 (FREQ/SDA), U7.9 (PBTL/SCL), U7.18 (DGND), U7.22 (PGND), U7.27 (PGND), U7.31 (GGND), U7.33 (EP), U8.8 (FREQ/SDA), U8.9 (PBTL/SCL), U8.18 (DGND), U8.22 (PGND), U8.27 (PGND), U8.31 (GGND), U8.33 (EP), U9.2 (GND), U10.1 (PGND), U10.9 (FSEL), U10.16 (PSEL), U10.20 (DGND), U10.25 (ZGND), U10.26 (AGNDL), U10.31 (AGNDR), U11.4 (GND), X1.2 (GND), Y1.2, Y1.4
unnamed: C2.2, R3.1, U1.16 (PLLFILT)
unnamed: C6.2, R3.2
unnamed: C27.2, R13.2
unnamed: C30.1, U3.6 (VBST)
unnamed: C30.2, L1.2, U3.2 (SW)
unnamed: C48.1, C49.1, U7.5 (ANA_REF)
unnamed: C48.2, U7.3 (ANA_REG)
unnamed: C49.2, U7.4 (VCOM)
unnamed: C50.1, U7.2 (SFT_CLIP), U7.32 (GVDD_REG)
unnamed: C54.1, U7.30 (BSTRPA+)
unnamed: C54.2, L3.1, U7.29 (SPK_OUTA+)
unnamed: C55.1, U7.25 (BSTRPA-)
unnamed: C55.2, L4.1, U7.26 (SPK_OUTA-)
unnamed: C56.1, U7.19 (BSTRPB+)
unnamed: C56.2, L5.1, U7.20 (SPK_OUTB+)
unnamed: C57.1, U7.24 (BSTRPB-)
unnamed: C57.2, L6.1, U7.23 (SPK_OUTB-)
unnamed: C62.1, C63.1, U8.5 (ANA_REF)
unnamed: C62.2, U8.3 (ANA_REG)
unnamed: C63.2, U8.4 (VCOM)
unnamed: C64.1, U8.2 (SFT_CLIP), U8.32 (GVDD_REG)
unnamed: C68.1, U8.30 (BSTRPA+)
unnamed: C68.2, L7.1, U8.29 (SPK_OUTA+)
unnamed: C69.1, U8.25 (BSTRPA-)
unnamed: C69.2, L8.1, U8.26 (SPK_OUTA-)
unnamed: C70.1, U8.19 (BSTRPB+)
unnamed: C70.2, L9.1, U8.20 (SPK_OUTB+)
unnamed: C71.1, U8.24 (BSTRPB-)
unnamed: C71.2, L10.1, U8.23 (SPK_OUTB-)
unnamed: C76.1, R33.2, U10.12 (XTI), Y1.1
unnamed: C77.1, R33.1, U10.13 (XTO), Y1.3
unnamed: C78.1, U10.32 (VCOM)
unnamed: C85.1, J9.1 (In), R41.1
unnamed: C86.1, R42.2, R43.1
unnamed: C86.2, T1.1 (In)
unnamed: J3.12 (GPIO18/PWM0), R14.1
unnamed: J3.35 (GPIO19/MISO1), R15.1
unnamed: J3.40 (GPIO21/SCLK1), R16.1
unnamed: J8.2 (D-), U9.1 (I/O1)
unnamed: J8.3 (D+), U9.3 (I/O2)
unnamed: J10.1 (In), T1.6 (Out)
unnamed: J10.2 (Ext), T1.4 (OutRet)
unnamed: R5.2, U1.41 (SDATA_OUT0)
unnamed: R6.2, U1.44 (SDATA_OUT1)
unnamed: R7.2, U1.47 (LRCLK_OUT2/MP8)
unnamed: R8.2, U1.48 (BCLK_OUT2)
unnamed: R9.2, U1.49 (SDATA_OUT2)
unnamed: R10.2, U1.50 (LRCLK_OUT3/MP9)
unnamed: R11.2, U1.51 (BCLK_OUT3)
unnamed: R12.2, U1.52 (SDATA_OUT3)
unnamed: R35.1, U9.6 (I/O1)
unnamed: R36.1, U9.4 (I/O2)
unnamed: R37.2, U10.5 (FUNC0)
unnamed: R38.2, U10.19 (FUNC1)
unnamed: R39.2, U10.17 (DOUT)
unnamed: R40.1, U10.15 (DT)
unnamed: U5.2 (A), X1.3 (OUT)
PI_3V3: J3.1 (3V3), R21.2, R22.2, U2.3 (Vs)
VAA: C51.1, C52.1, C53.1, C65.1, C66.1, C67.1, U7.1 (AVDD), U7.21 (PVDD), U7.28 (PVDD), U8.1 (AVDD), U8.21 (PVDD), U8.28 (PVDD)
VBUS: J8.1 (VBUS), R34.2, U9.5 (VBUS), U10.3 (HOST)
