blus-audio/hardware/blus-mini-mk2/blus-mini-mk2.ioc

Mcu.UserName=STM32H723VGTx
PA1.Signal=SAI4_MCLK_B
PA11.Signal=SPI2_NSS
PA13(JTMS/SWDIO).Signal=DEBUG_JTMS-SWDIO
PA14(JTCK/SWCLK).Signal=DEBUG_JTCK-SWCLK
PA15(JTDI).Signal=DEBUG_JTDI
PA3.Signal=USB_OTG_HS_ULPI_D0
PA5.Signal=USB_OTG_HS_ULPI_CK
PA8.Signal=USB_OTG_HS_SOF
PA9.Signal=SPI2_SCK
PB0.Signal=USB_OTG_HS_ULPI_D1
PB1.Signal=USB_OTG_HS_ULPI_D2
PB10.Signal=USB_OTG_HS_ULPI_D3
PB11.Signal=USB_OTG_HS_ULPI_D4
PB12.Signal=USB_OTG_HS_ULPI_D5
PB13.Signal=USB_OTG_HS_ULPI_D6
PB14.Signal=SPI2_MISO
PB15.Signal=SPI2_MOSI
PB5.Signal=USB_OTG_HS_ULPI_D7
PB6.Signal=I2C1_SCL
PB7.Signal=I2C1_SDA
PC0.Signal=USB_OTG_HS_ULPI_STP
PC1.Signal=SAI4_SD_A
PC2_C.Signal=USB_OTG_HS_ULPI_DIR
PC3_C.Signal=USB_OTG_HS_ULPI_NXT
PD12.Signal=SAI4_FS_A
PD13.Signal=SAI4_SCK_A
PD5.Signal=USART2_TX
PD6.Signal=USART2_RX
PD7.Signal=SPDIFRX1_IN0
PD8.Signal=SPDIFRX1_IN1
PE0.Signal=SAI4_MCLK_A
PE11.Signal=SAI4_SD_B
PE12.Signal=SAI4_SCK_B
PE13.Signal=SAI4_FS_B
PE2.Signal=SAI1_MCLK_A
PE3.Signal=SAI1_SD_B
PE4.Signal=SAI1_FS_A
PE5.Signal=SAI1_SCK_A
PE6.Signal=SAI1_SD_A
PE7.Signal=S_TIM1_ETR
PH0-OSC_IN.Signal=RCC_OSC_IN
