blus-audio/hardware/(commit log)

2021-04-02 Initial commit hardware WIP
    [I2S-AMP-2CH.sch, I2S-Amp1.sch, I2S-Amp2.sch, SPDIF.sch, SPDIFin.sch, SPDIFout.sch, clock.sch, dsp-amplifier-x4.kicad_pcb]
2021-04-02 various fixes
    [I2S-AMP-2CH.sch, dsp-amplifier-x4.kicad_pcb, dsp-amplifier-x4.sch]
2021-04-03 started routing
    [I2S-AMP-2CH.sch, SPDIF.sch, clock.sch, dsp-amplifier-x4.kicad_pcb, dsp-amplifier-x4.sch, i2c_eeprom.sch, power.sch, usb_i2s.sch]
2021-04-03 routing progress
    [I2S-AMP-2CH.sch, dsp-amplifier-x4.kicad_pcb, dsp-amplifier-x4.sch, usb_i2s.sch]
2021-04-03 routing, added 4 layers
    [dsp-amplifier-x4.kicad_pcb, dsp-amplifier-x4.sch, usb_i2s.sch]
2021-04-04 bugfixes, made smaller
    [I2S-AMP-2CH.sch, dsp-amplifier-x4.kicad_pcb, dsp-amplifier-x4.sch, i2c_eeprom.sch, usb_i2s.sch]
2021-04-04 connector for ac
    [dsp-amplifier-x4.kicad_pcb, dsp-amplifier-x4.sch]
2021-04-05 style fixes, spi/i2c
    [I2S-AMP-2CH.sch, dsp-amplifier-x4.kicad_pcb, dsp-amplifier-x4.sch, i2c_eeprom.sch]
2021-04-05 release candidate 1, drc clean
    [dsp-amplifier-x4.kicad_pcb]
2021-04-05 new sockets
    [dsp-amplifier-x4.kicad_pcb, dsp-amplifier-x4.sch]
2021-04-06 production v0.1 with gerber
    [dsp-amplifier-x4.kicad_pcb, dsp-amplifier-x4.sch]
2021-04-06 cleanup, added schematics pdf
2021-04-07 added change doc, added missing folders
    [dsp-amplifier-x4-B_Cu.gbr, dsp-amplifier-x4-B_Mask.gbr, dsp-amplifier-x4-B_Paste.gbr, dsp-amplifier-x4-B_SilkS.gbr, dsp-amplifier-x4-Edge_Cuts.gbr, dsp-amplifier-x4-F_Cu.gbr, dsp-amplifier-x4-F_Mask.gbr, dsp-amplifier-x4-F_Paste.gbr]
2021-04-21 fixed usbi/ext header positions
    [I2S-AMP-2CH.sch, SPDIF.sch, dsp-amplifier-x4.kicad_pcb, dsp-amplifier-x4.sch]
2021-05-04 hardware bugfixes
    [I2S-AMP-2CH.sch, SPDIF.sch, clock.sch, dsp-amplifier-x4.kicad_pcb, dsp-amplifier-x4.sch, i2c_eeprom.sch, power.sch, usb_i2s.sch]
2021-05-06 various bugfixes
    [I2S-AMP-2CH.sch, dsp-amplifier-x4.kicad_pcb, dsp-amplifier-x4.sch, usb_i2s.sch]
2021-05-06 software gain control
    [dsp-amplifier-x4.kicad_pcb, dsp-amplifier-x4.sch]
2021-05-06 connect pi i2c to header
    [I2S-AMP-2CH.sch, SPDIF.sch, clock.sch, dsp-amplifier-x4.kicad_pcb, dsp-amplifier-x4.sch, i2c_eeprom.sch, power.sch, usb_i2s.sch]
2021-05-06 fixes to plug placement
    [dsp-amplifier-x4.kicad_pcb, dsp-amplifier-x4.sch]
2021-05-06 minor layout tweaks
    [dsp-amplifier-x4.kicad_pcb]
2021-05-07 beautify traces
    [dsp-amplifier-x4.kicad_pcb]
2021-05-07 v1 production version
    [dsp-amplifier-x4.kicad_pcb]
2021-05-10 add missing files
    [blus_v1_bom.csv, blus_v1_bom.xlsx]
2021-05-12 add v1 gerbers
    [dsp-amplifier-x4-B_Cu.gbl, dsp-amplifier-x4-B_Mask.gbs, dsp-amplifier-x4-B_Paste.gbp, dsp-amplifier-x4-B_SilkS.gbo, dsp-amplifier-x4-Edge_Cuts.gm1, dsp-amplifier-x4-F_Cu.gtl, dsp-amplifier-x4-F_Mask.gts, dsp-amplifier-x4-F_Paste.gtp]
2021-06-03 m3 to m2.5 rpi holes
    [dsp-amplifier-x4.kicad_pcb]
2022-04-10 chore: cleanup
    [blus_v1_bom.csv, blus_v1_bom.xlsx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]
2022-04-10 slight adjustments
    [dsp-amplifier-x4.kicad_pcb, dsp-amplifier-x4.sch]
2022-04-10 mostly ready
    [dsp-amplifier-x4.kicad_pcb, dsp-amplifier-x4.sch, power.sch, usb_i2s.sch]
2022-04-10 feat: finalize layout for smaller blus
    [I2S-AMP-2CH.kicad_sch, SPDIF.kicad_sch, clock.kicad_sch, dsp-amplifier-x4.kicad_pcb, dsp-amplifier-x4.kicad_sch, i2c_eeprom.kicad_sch, power.kicad_sch, usb_i2s.kicad_sch]
2022-10-04 Updated power supply
    [I2S-AMP-2CH.kicad_sch, SPDIF.kicad_sch, clock.kicad_sch, dsp-amplifier-x4.kicad_pcb, dsp-amplifier-x4.kicad_sch, i2c_eeprom.kicad_sch, power.kicad_sch, power_15v.kicad_sch]
2022-10-16 Updated clock buffer
    [I2S-AMP-2CH.kicad_sch, clock.kicad_sch, dsp-amplifier-x4.kicad_pcb, dsp-amplifier-x4.kicad_sch]
2023-02-03 feat: updated amplifier IC, finalized design
    [I2S-AMP-2CH.kicad_sch, SPDIF.kicad_sch, amplifiers.kicad_sch, clock.kicad_sch, dsp-amplifier-x4.kicad_sch, i2c_eeprom.kicad_sch, mcu.kicad_sch, power_15v.kicad_sch]
2023-02-18 prod. version blus mini a
    [I2S-AMP-2CH.kicad_sch, SPDIF.kicad_sch, amplifiers.kicad_sch, clock.kicad_sch, dsp-amplifier-x4.kicad_sch, i2c_eeprom.kicad_sch, mcu.kicad_sch, power_15v.kicad_sch]
2023-02-18 feat: added 3d models
    [CUI_DEVICES_RCJ-021.step, c-5787834-1-c-3d.stp, clock.kicad_sch, dsp-amplifier-x4.kicad_sch, ptv09a-4x20f-xxxx.stp]
2023-04-15 feat!: wip, version b
    [CUI_DEVICES_RCJ-021.step, I2S-AMP-2CH.kicad_sch, SPDIF.kicad_sch, amplifiers.kicad_sch, c-5787834-1-c-3d.stp, clock.kicad_sch, dsp-amplifier-x4.kicad_sch, i2c_eeprom.kicad_sch]
2023-05-05 fix: issues with rev a
    [dsp-amplifier-x4.kicad_sch, mcu.kicad_sch]
2023-05-07 chore: restructure and documentation
    [amplifiers.kicad_sch, clock.kicad_sch, dsp-amplifier-x4.kicad_sch, mcu.kicad_sch, power.kicad_sch, spdif.kicad_sch, spi_eeprom.kicad_sch, tas2780.kicad_sch]
2023-05-07 chore: add license, local kicad library
2023-05-10 chore: add title blocks, extend readme minor changes
    [amplifiers.kicad_sch, clock.kicad_sch, dsp-amplifier-x4.kicad_sch, mcu.kicad_sch, power.kicad_sch, spdif.kicad_sch, spi_eeprom.kicad_sch, tas2780.kicad_sch]
2023-10-10 [pre-commit.ci] pre-commit autoupdate
    updates:
    - [github.com/pre-commit/pre-commit-hooks: v4.4.0 → v4.5.0](https://github.com/pre-commit/pre-commit-hooks/compare/v4.4.0...v4.5.0)
2023-12-21 chore: update submodules, minor part changes
    [amplifiers.kicad_sch, clock.kicad_sch, dsp-amplifier-x4.kicad_sch, mcu.kicad_sch, power.kicad_sch, spdif.kicad_sch, spi_eeprom.kicad_sch, tas2780.kicad_sch]
2024-05-06 [pre-commit.ci] pre-commit autoupdate
    - [github.com/pre-commit/pre-commit-hooks: v4.5.0 → v4.6.0](https://github.com/pre-commit/pre-commit-hooks/compare/v4.5.0...v4.6.0)
    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
2024-06-10 feat: initial h723 work
    [amplifiers.kicad_sch, blus-mini-mk2.kicad_pcb, blus-mini-mk2.kicad_sch, clock.kicad_sch, mcu.kicad_sch, power.kicad_sch, spdif.kicad_sch, spi_eeprom.kicad_sch]
2024-06-10 feat: wip, added most components
    [amplifiers.kicad_sch, blus-mini-mk2.kicad_pcb, blus-mini-mk2.kicad_sch, clock.kicad_sch, ethernet.kicad_sch, mcu.kicad_sch, power.kicad_sch, spdif.kicad_sch]
2024-06-10 feat: production version, blus mini mk2 a
    [amplifiers.kicad_sch, blus-mini-mk2.kicad_pcb, blus-mini-mk2.kicad_sch, clock.kicad_sch, mcu.kicad_sch, power.kicad_sch, spdif.kicad_sch, tas2780.kicad_sch]
2024-10-10 [pre-commit.ci] pre-commit autoupdate
    - [github.com/pre-commit/pre-commit-hooks: v4.6.0 → v5.0.0](https://github.com/pre-commit/pre-commit-hooks/compare/v4.6.0...v5.0.0)
    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
2024-11-22 fix: update to rev b, capacitor location
    [amplifiers.kicad_sch, blus-mini-mk2.kicad_pcb, blus-mini-mk2.kicad_sch, clock.kicad_sch, mcu.kicad_sch, power.kicad_sch, spdif.kicad_sch, tas2780.kicad_sch]
